taidp-uit-ce/DESIGN-OF-A-RISC-V-32-BIT-PROCESSOR-BASED-SOC-WITH-H.264-INTRA-FRAME-ENCODING-ON-FPGA/rtl/h264_video_codec_ip/README.md

# H.264 Video Encoder IP Overview
<p align="center">
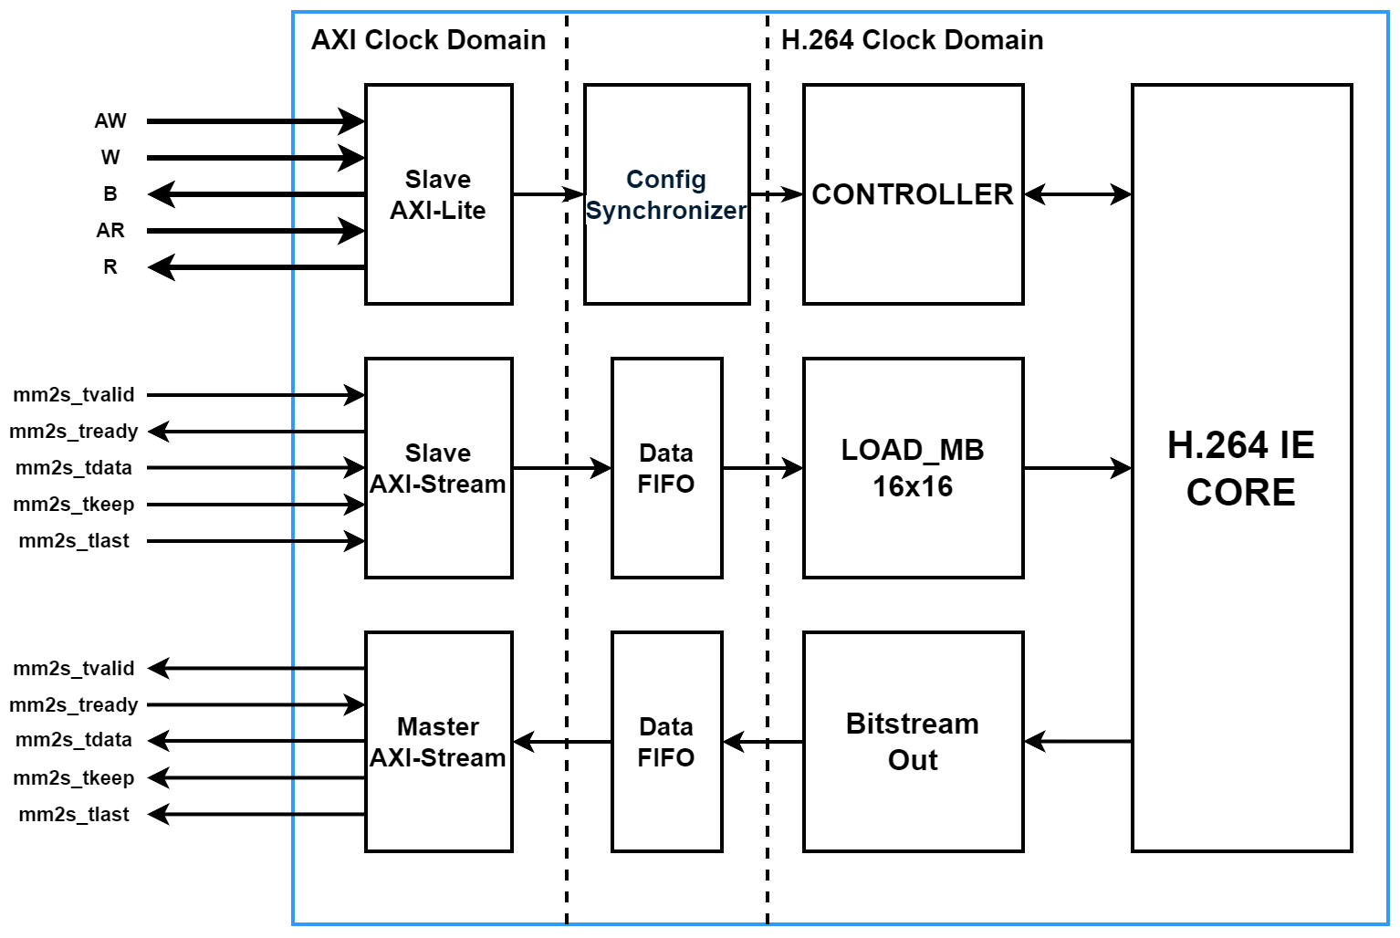
[picture p5: images/h264/H264_IP.drawio.png]
description
  
</p>

# Function Description

## AXI-Lite (slave):
- Provides a memory-mapped control/status interface accessible by the RV32I CPU
- Used to configure encoder parameters and monitor encoding status
- Accessible registers include:
  - `start`: Start signal for H.264 encoding
  - `done`: Asserted when one frame has been encoded
  - `qp`: Quantization parameter
  - `width`: Frame width (in pixels)
  - `height`: Frame height (in pixels)
  
## AXI-Stream (slave):
- Receives raw video input from AXI DMA (MM2S) via a slave-stream port
- Data is buffered into an asynchronous FIFO

## AXI-Stream (master):
- Sends compressed bitstream data to AXI DMA (S2MM) via a master-stream port
- FSM packs data into 64-bit transfers
- Handles `tlast` and `tkeep` signals properly at frame boundaries
  
## Config Synchronizer:
- Synchronizes control signals across clock domains
- Uses 2FF (two flip-flop) synchronizers for single-bit signals  
- For multi-bit synchronizers, see: [Multi-clock design techniques](https://nguyenquanicd.blogspot.com/2020/02/multi-clock-design-bai-3-ky-thuat-ong.html)

## Asynchronous FIFOs:
- Used for clock domain crossing (CDC)
- Buffers data between CPU and encoder working at different clock frequencies
  
## H.264 Intra Encoder Core (based on open-source)
- Open-source H.264 intra-frame encoder used in this project
- Reference: [https://github.com/openasic-org/xk264/](https://github.com/openasic-org/xk264/)
