taidp-uit-ce/DESIGN-OF-A-RISC-V-32-BIT-PROCESSOR-BASED-SOC-WITH-H.264-INTRA-FRAME-ENCODING-ON-FPGA/rtl/riscv_rv32i_cpu/README.md

## System Architecture
<p align="center">
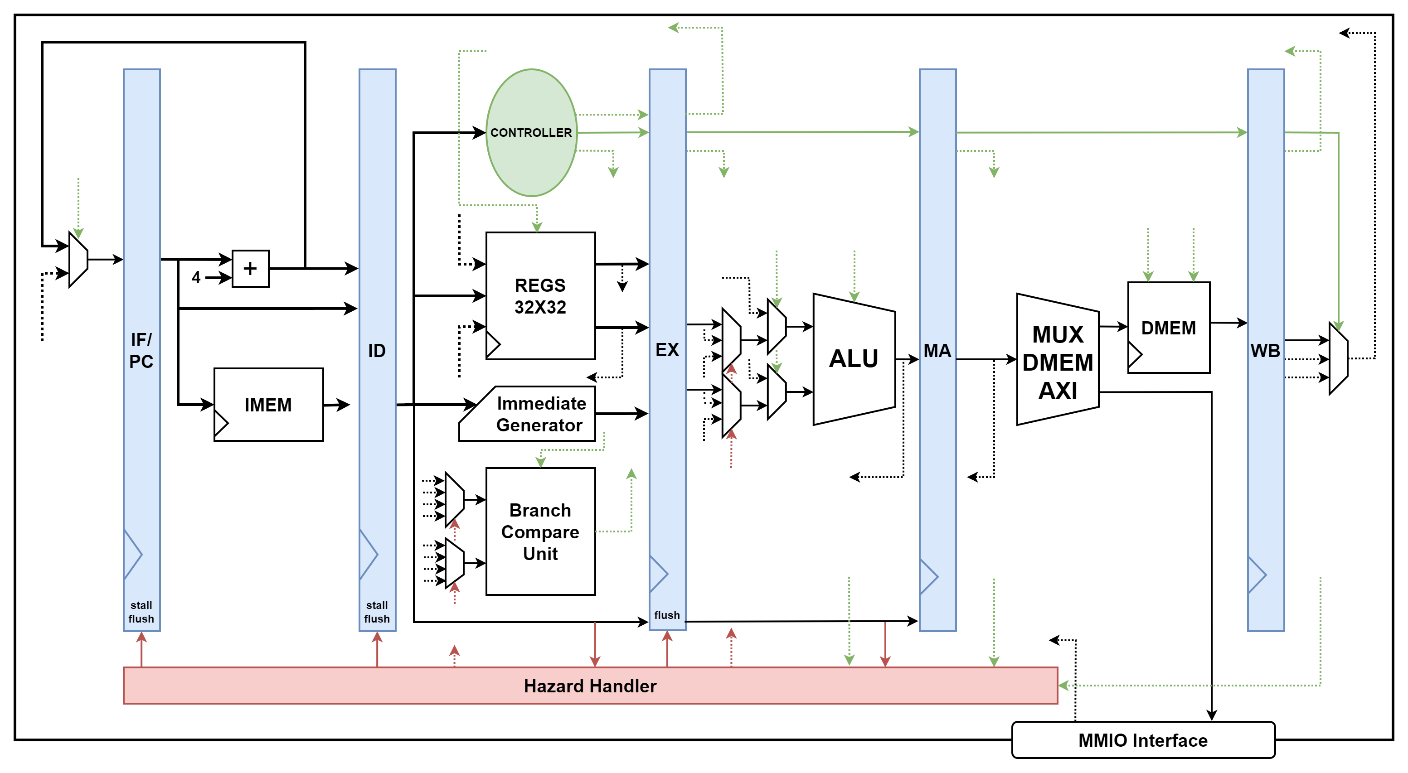
[picture p6: images/rv32i/rv32i_final.drawio.png]
description
  
</p>
