taidp-uit-ce/DESIGN-OF-A-RISC-V-32-BIT-PROCESSOR-BASED-SOC-WITH-H.264-INTRA-FRAME-ENCODING-ON-FPGA/images/h264/load_pipeline.drawio.png

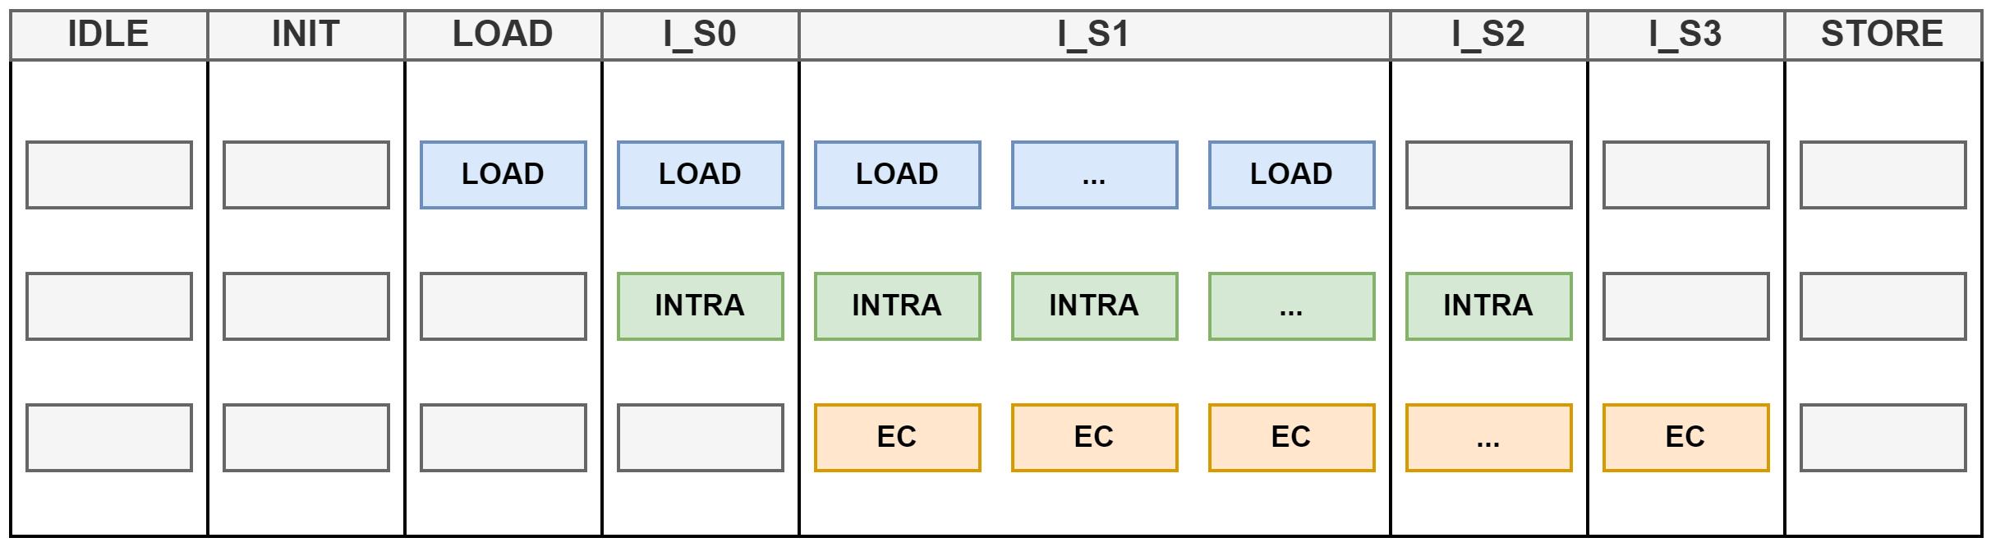
images/h264/load_pipeline.drawio.png
