taidp-uit-ce/DESIGN-OF-A-RISC-V-32-BIT-PROCESSOR-BASED-SOC-WITH-H.264-INTRA-FRAME-ENCODING-ON-FPGA/images/rv32i/hazard/hazard.drawio.png

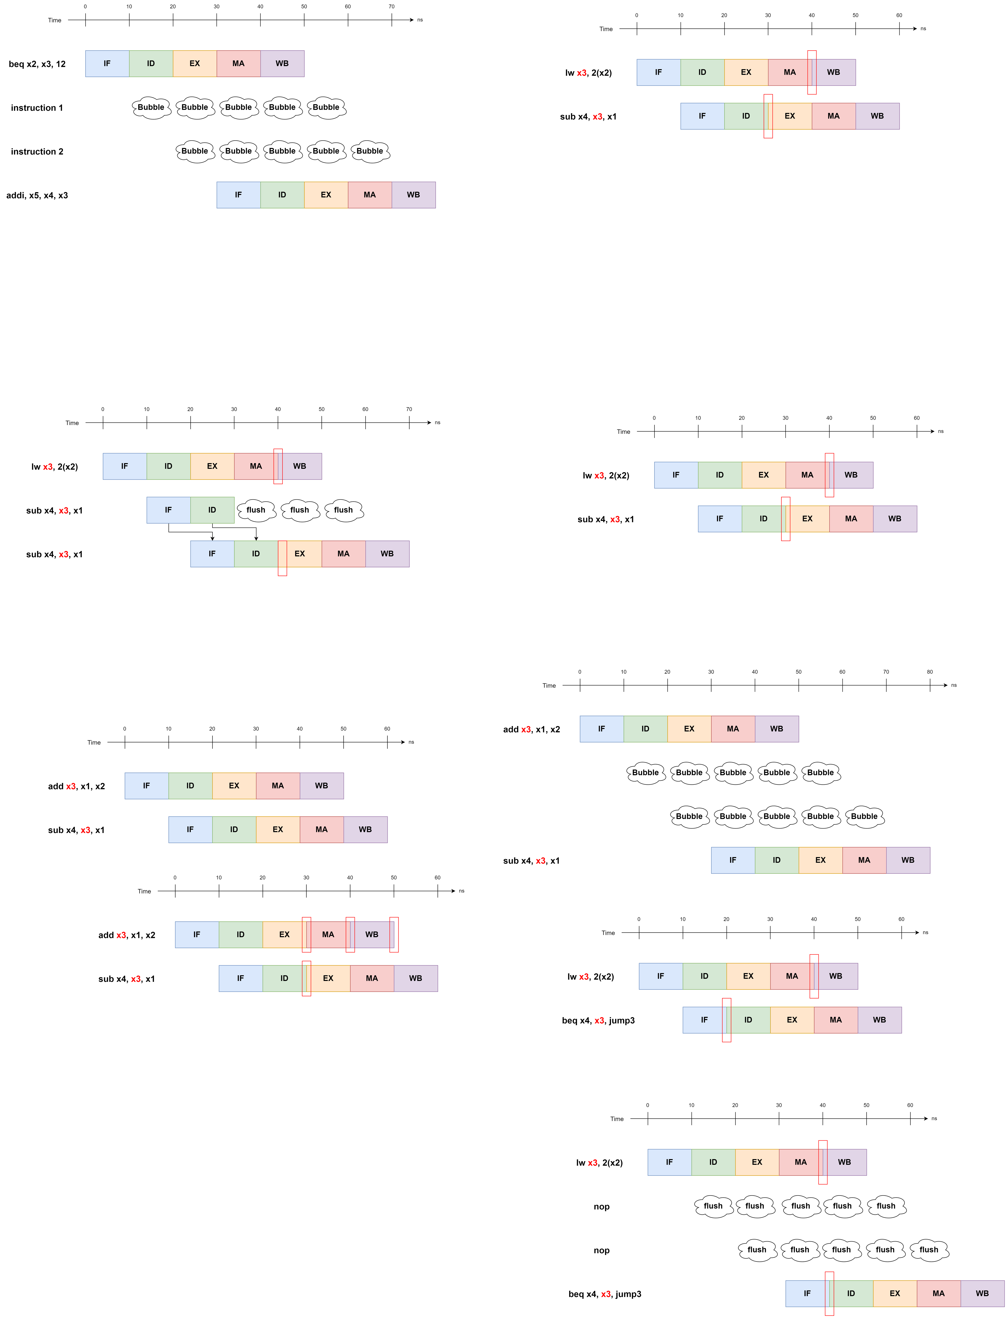
images/rv32i/hazard/hazard.drawio.png
