taidp-uit-ce/DESIGN-OF-A-RISC-V-32-BIT-PROCESSOR-BASED-SOC-WITH-H.264-INTRA-FRAME-ENCODING-ON-FPGA/rtl/h264_video_codec_ip/h264_core/rf_2p.v

`include "enc_defines.v"

module rf_2p (
				clka    ,  
				cena_i  ,
		        addra_i ,
		        dataa_o ,
				clkb    ,     
				cenb_i  ,   
				wenb_i  ,   
				addrb_i	,  
				datab_i
);

// ********************************************
//                                             
//    Parameter DECLARATION                    
//                                             
// ********************************************
parameter     		Word_Width=32;
parameter	  		Addr_Width=8;

// ********************************************
//                                             
//    Input/Output DECLARATION                    
//                                             
// ********************************************
// A port
input                     clka;      // clock input
input   		          cena_i;    // chip enable, low active
input   [Addr_Width-1:0]  addra_i;   // address input
output	[Word_Width-1:0]  dataa_o;   // data output

// B Port
input                     clkb;      // clock input                     
input   		          cenb_i;    // chip enable, low active      
input   		          wenb_i;    // write enable, low active        
input   [Addr_Width-1:0]  addrb_i;   // address input                   
input   [Word_Width-1:0]  datab_i;   // data input                     

// ********************************************
//                                             
//    Register DECLARATION                 
//                                             
// ********************************************
reg    [Word_Width-1:0]   mem_array[(1<<Addr_Width)-1:0];

// ********************************************
//                                             
//    Wire DECLARATION                 
//                                             
// ********************************************
reg	   [Word_Width-1:0]  dataa_r;

// ********************************************
//                                             
//    Logic DECLARATION                 
//                                             
// ********************************************
// -- A Port --//
always @(posedge clka) begin
	if (!cena_i)
		dataa_r <= mem_array[addra_i];
	else
		dataa_r <= 'bx;
end

assign dataa_o = dataa_r;

// -- B Port --//
always @(posedge clkb) begin                
	if(!cenb_i && !wenb_i) 
		mem_array[addrb_i] <= datab_i;
end

endmodule
